tuan1111nc/Obstacle-Avoidance-Mobile-Robot/xe_dua.kicad_sch

## KiCad design xe_dua.kicad_sch (2026-11-10)

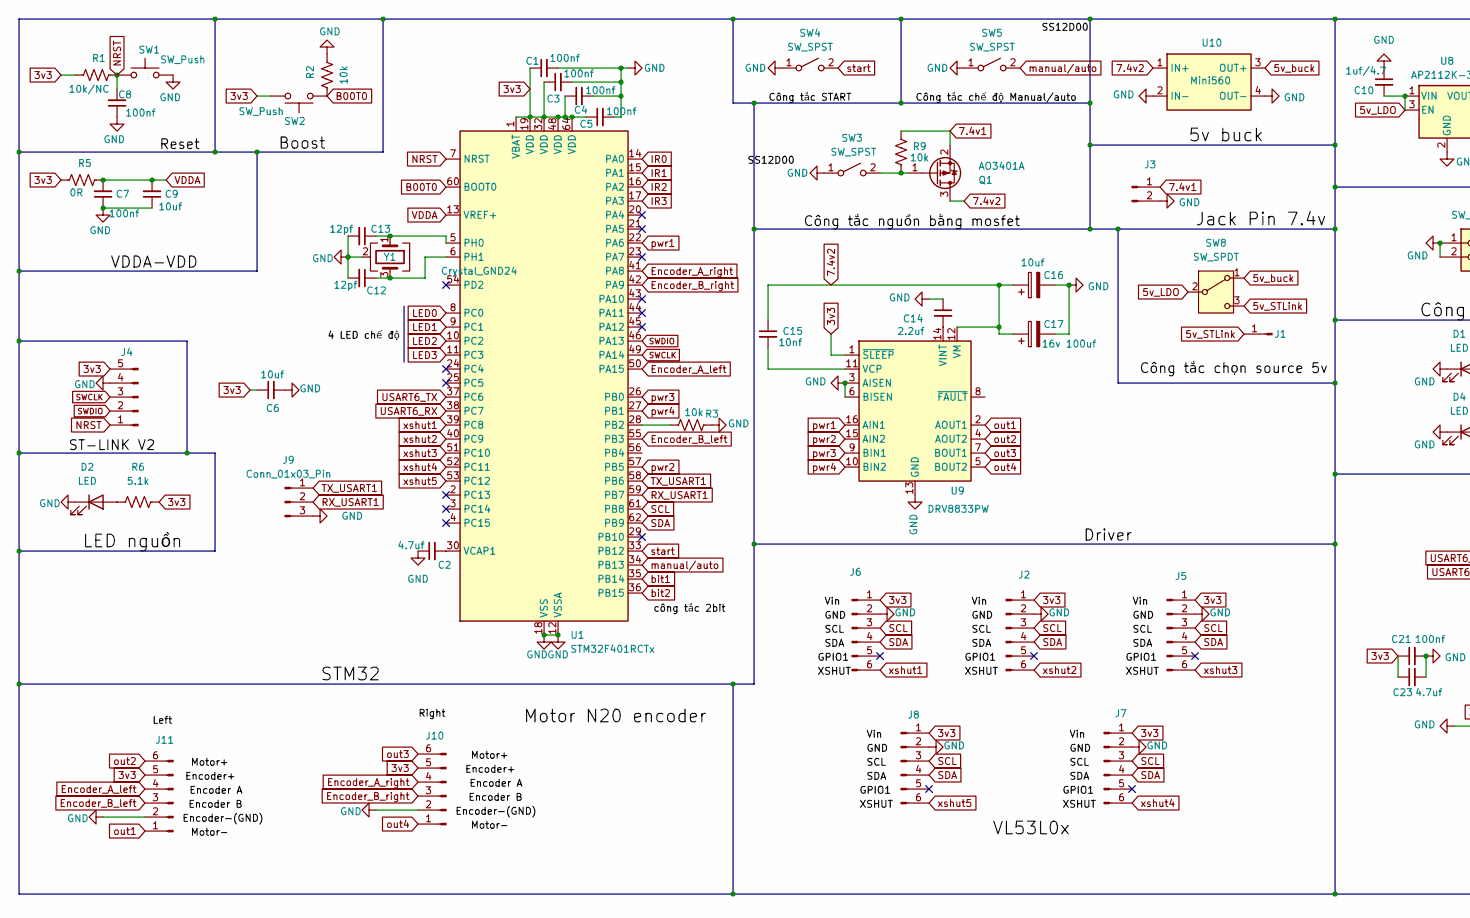
[picture p1: schematic xe_dua.kicad_sch, part in row 1, column 1]

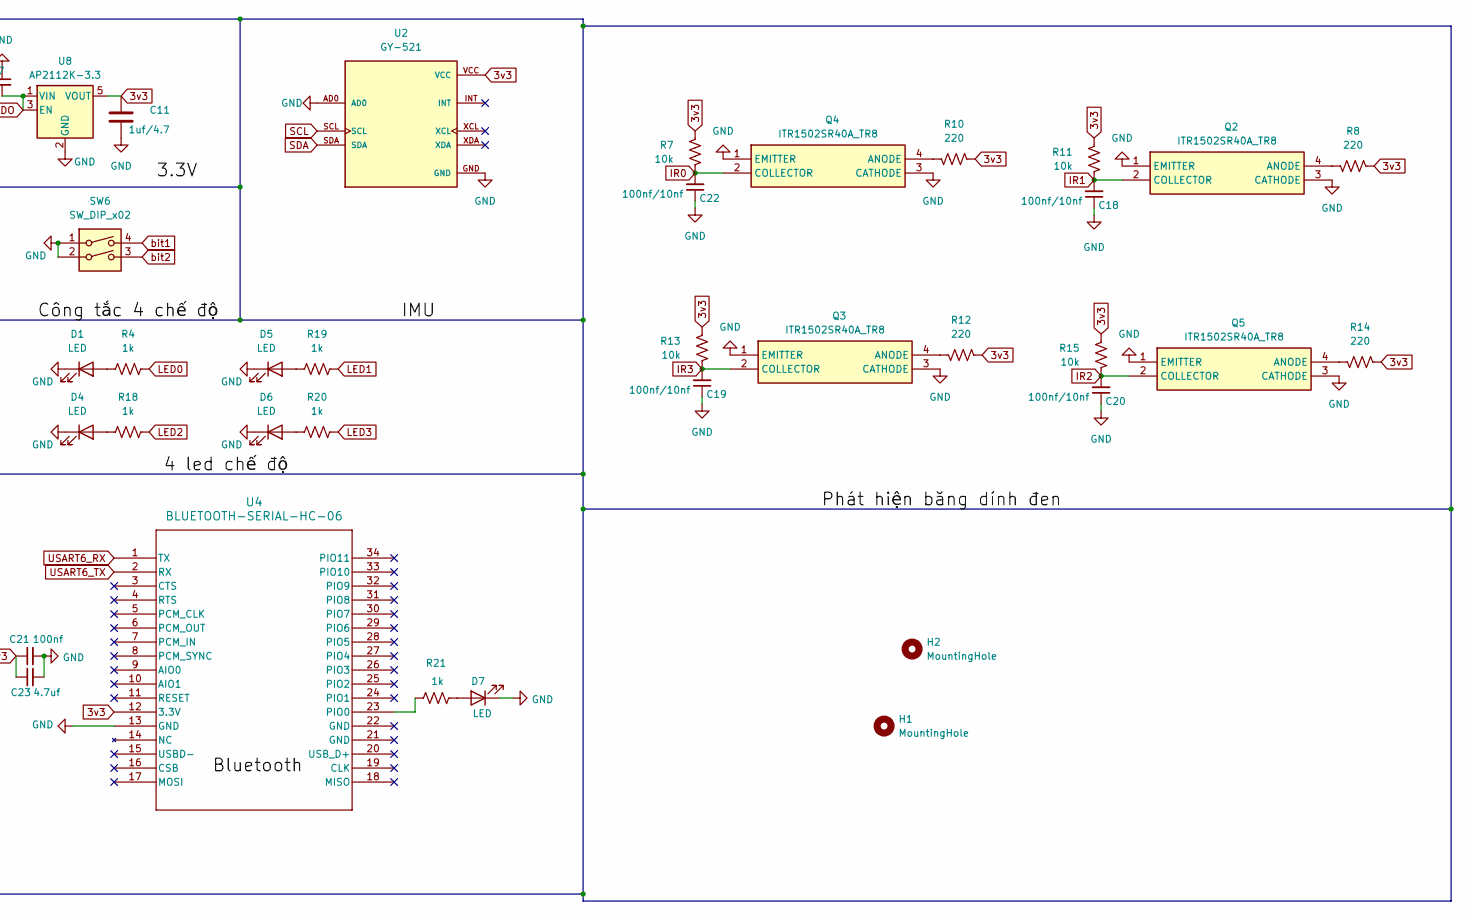
[picture p2: schematic xe_dua.kicad_sch, part in row 1, column 2]

Parts:
C1, C3, C4, C5, C7, C8, C21: 100nf; C_0603_1608Metric_Pad1.08x0.95mm_HandSolder
C2, C23: 4.7uf; C_1206_3216Metric_Pad1.33x1.80mm_HandSolder
C6, C9: 10uf; C_1206_3216Metric_Pad1.33x1.80mm_HandSolder
C10, C11: 1uf/4.7; C_1206_3216Metric_Pad1.33x1.80mm_HandSolder
C12, C13: 12pf; C_0402_1005Metric_Pad0.74x0.62mm_HandSolder
C14: 2.2uf; C_0805_2012Metric_Pad1.18x1.45mm_HandSolder
C15: 10nf; C_0805_2012Metric_Pad1.18x1.45mm_HandSolder
C16: 10uf; CP_EIA-3216-18_Kemet-A_HandSolder
C17: 16v 100uf; CP_Elec_5x5.4
C18, C19, C20, C22: 100nf/10nf; C_0603_1608Metric_Pad1.08x0.95mm_HandSolder
D1, D2, D4, D5, D6, D7: LED; LED_0805_2012Metric_Pad1.15x1.40mm_HandSolder
H1, H2: MountingHole; TestPoint_Loop_D3.80mm_Drill2.5mm
J1: Conn_01x01_Pin; PinHeader_1x01_P2.54mm_Vertical
J2, J5, J6, J7, J8: Conn_01x06_Pin; PinSocket_1x06_P2.54mm_Vertical
J3: Conn_01x02_Pin; JST_PH_B2B-PH-K_1x02_P2.00mm_Vertical
J4: Conn_01x05_Pin; PinHeader_1x05_P2.54mm_Vertical
J9: Conn_01x03_Pin; PinHeader_1x03_P2.54mm_Vertical
J10, J11: Conn_01x06_Pin; JST_ZH_B6B-ZR_1x06_P1.50mm_Vertical
Q1: AO3401A; SOT-23
Q2, Q3, Q4, Q5: ITR1502SR40A_TR8; ITR1502SR40ATR8; Manufacturer_Part_Number ITR1502SR40A/TR8; Mouser Part Number 638-ITR1502SR40A/TR8
R1: 10k/NC; R_0603_1608Metric
R2, R3, R7, R9, R11, R13, R15: 10k; R_0603_1608Metric_Pad0.98x0.95mm_HandSolder
R4, R18, R19, R20, R21: 1k; R_0603_1608Metric
R5: 0R; R_0805_2012Metric
R6: 5.1k; R_0603_1608Metric
R8, R10, R12, R14: 220; R_0805_2012Metric_Pad1.20x1.40mm_HandSolder
SW1, SW2: SW_Push; SW_Push_1P1T_NO_CK_KMR2
SW3, SW5: SW_SPST; SW_Slide_SPDT_Straight_CK_OS102011MS2Q
SW4: SW_SPST; SW_Push_1P1T_NO_CK_KMR2
SW6: SW_DIP_x02; SW_DIP_SPSTx02_Slide_9.78x7.26mm_W7.62mm_P2.54mm
SW8: SW_SPDT; SW_Slide_SPDT_Straight_CK_OS102011MS2Q
U1: STM32F401RCTx; LQFP-64_10x10mm_P0.5mm
U2: GY-521; MODULE_GY-521; PARTREV NA
U4: BLUETOOTH-SERIAL-HC-06; HC-06_OMX
U8: AP2112K-3.3; SOT-23-5
U9: DRV8833PW; TSSOP-16_4.4x5mm_P0.65mm
U10: Mini560; Mini560_Castellated
Y1: Crystal_GND24; Crystal_SMD_3225-4Pin_3.2x2.5mm

Connections:
3v3: C1.1, C3.1, C4.1, C5.1, C6.1, C11.1, C21.1, C23.1, J2.1, J4.5, J5.1, J6.1, J7.1, J8.1, J10.5, J11.5, R1.1, R5.1, R6.2, R7.2, R8.1, R10.1, R11.2, R12.1, R13.2, R14.1, R15.2, SW2.2, U1.1 (VBAT), U1.19 (VDD), U1.32 (VDD), U1.48 (VDD), U1.64 (VDD), U2.VCC, U4.12 (3.3V), U8.5 (VOUT), U9.1 (~SLEEP)
5v_LDO: C10.2, SW8.2 (B), U8.1 (VIN), U8.3 (EN)
5v_STLink: J1.1, SW8.3 (C)
5v_buck: SW8.1 (A), U10.3 (OUT+)
7.4v1: J3.1, Q1.2 (S), R9.1
7.4v2: C15.1, C16.1, C17.1, Q1.3 (D), U9.12 (VM), U10.1 (IN+)
B00T0: R2.1, SW2.1, U1.60 (BOOT0)
Encoder_A_left: J11.4, U1.50 (PA15)
Encoder_A_right: J10.4, U1.41 (PA8)
Encoder_B_left: J11.3, U1.55 (PB3)
Encoder_B_right: J10.3, U1.42 (PA9)
GND: C1.2, C2.1, C3.2, C4.2, C5.2, C6.2, C7.1, C8.1, C9.1, C10.1, C11.2, C12.2, C13.2, C14.1, C16.2, C17.2, C18.1, C19.1, C20.1, C21.2, C22.1, C23.2, D1.1 (K), D2.1 (K), D4.1 (K), D5.1 (K), D6.1 (K), D7.1 (K), J2.2, J3.2, J4.4, J5.2, J6.2, J7.2, J8.2, J9.3, J10.2, J11.2, Q2.1 (EMITTER), Q2.3 (CATHODE), Q3.1 (EMITTER), Q3.3 (CATHODE), Q4.1 (EMITTER), Q4.3 (CATHODE), Q5.1 (EMITTER), Q5.3 (CATHODE), R2.2, R3.1, SW1.2, SW3.1 (A), SW4.1 (A), SW5.1 (A), SW6.1, SW6.2, U1.12 (VSSA), U1.18 (VSS), U1.31 (VSS), U1.47 (VSS), U1.63 (VSS), U2.AD0, U2.GND, U4.13 (GND), U8.2 (GND), U9.3 (AISEN), U9.6 (BISEN), U9.13 (GND), U10.2 (IN-), U10.4 (OUT-), Y1.2 (G), Y1.4 (G)
IR0: C22.2, Q4.2 (COLLECTOR), R7.1, U1.14 (PA0)
IR1: C18.2, Q2.2 (COLLECTOR), R11.1, U1.15 (PA1)
IR2: C20.2, Q5.2 (COLLECTOR), R15.1, U1.16 (PA2)
IR3: C19.2, Q3.2 (COLLECTOR), R13.1, U1.17 (PA3)
LED0: R4.2, U1.8 (PC0)
LED1: R19.2, U1.9 (PC1)
LED2: R18.1, U1.10 (PC2)
LED3: R20.2, U1.11 (PC3)
NRST: C8.2, J4.1, R1.2, SW1.1, U1.7 (NRST)
unnamed: C2.2, U1.30 (VCAP1)
unnamed: C12.1, U1.6 (PH1), Y1.3
unnamed: C13.1, U1.5 (PH0), Y1.1
unnamed: C14.2, U9.14 (VINT)
unnamed: C15.2, U9.11 (VCP)
unnamed: D1.2 (A), R4.1
unnamed: D2.2 (A), R6.1
unnamed: D4.2 (A), R18.2
unnamed: D5.2 (A), R19.1
unnamed: D6.2 (A), R20.1
unnamed: D7.2 (A), R21.2
unnamed: Q1.1 (G), R9.2, SW3.2 (B)
unnamed: Q2.4 (ANODE), R8.2
unnamed: Q3.4 (ANODE), R12.2
unnamed: Q4.4 (ANODE), R10.2
unnamed: Q5.4 (ANODE), R14.2
unnamed: R3.2, U1.28 (PB2)
unnamed: R21.1, U4.23 (PIO0)
RX_USART1: J9.2, U1.59 (PB7)
SCL: J2.3, J5.3, J6.3, J7.3, J8.3, U1.61 (PB8), U2.SCL
SDA: J2.4, J5.4, J6.4, J7.4, J8.4, U1.62 (PB9), U2.SDA
SWCLK: J4.3, U1.49 (PA14)
SWDIO: J4.2, U1.46 (PA13)
TX_USART1: J9.1, U1.58 (PB6)
USART6_RX: U1.38 (PC7), U4.1 (TX)
USART6_TX: U1.37 (PC6), U4.2 (RX)
VDDA: C7.2, C9.2, R5.2, U1.13 (VREF+)
bit1: SW6.4, U1.35 (PB14)
bit2: SW6.3, U1.36 (PB15)
manual/auto: SW5.2 (B), U1.34 (PB13)
out1: J11.1, U9.2 (AOUT1)
out2: J11.6, U9.4 (AOUT2)
out3: J10.6, U9.7 (BOUT1)
out4: J10.1, U9.5 (BOUT2)
pwr1: U1.22 (PA6), U9.16 (AIN1)
pwr2: U1.57 (PB5), U9.15 (AIN2)
pwr3: U1.26 (PB0), U9.9 (BIN1)
pwr4: U1.27 (PB1), U9.10 (BIN2)
start: SW4.2 (B), U1.33 (PB12)
xshut1: J6.6, U1.39 (PC8)
xshut2: J2.6, U1.40 (PC9)
xshut3: J5.6, U1.51 (PC10)
xshut4: J7.6, U1.52 (PC11)
xshut5: J8.6, U1.53 (PC12)
